spel-uchile/anemometroSonico/hardware/amplifier/amplifier_bom.xlsx

Quantity | SKU Digikey | Part number | Description | Reference
3 | 1276-1003-1-ND | CL21B104KBCNNNC | Capacitor 0.1uF (0805) | C101,C104,C105
1 | 1276-1029-1-ND | CL21B105KBFNNNE | Capacitor 1uF (0805) | C102
1 | 1276-2876-1-ND | CL31A106KBHNNNE | Capacitor 10uF (1206) | C103
1 | P1.00KFCT-ND | ERJ-8ENF1001V | Resistor 1k (1206) | R101
2 | LT1010CN8#PBF-ND | LT1010CN8#PBF | Power buffer LT1010 | U101,U103
1 | ED2609-ND | OSTTC022162 | Terminal block 2 pins | P101
2 | ED2610-ND | OSTTC032162 | Terminal block 3 pins | K101,K102
1 | INA2128UA-ND | INA2128UA | Instrumentation amplifier INA2128 | U102
1 | 1N4732ADICT-ND | 1N4732A-T | Zener diode 4.7v | D101
1 | P100FCT-ND | ERJ-8ENF1000V | Resistor 100 (1206) | R102
