spel-uchile/anemometroSonico/hardware/driver/driver_bom.xlsx

Quantity | SKU Digikey | Part number | Description | Reference
17 | 1276-1003-1-ND | CL21B104KBCNNNC | Capacitor 0.1uF (0805) | C101,C103,C104,C106,C109,C201,C301,C401,C203,C303,C403,C207,C307,C407,C208,C308,C408
13 | 1276-1029-1-ND | CL21B105KBFNNNE | Capacitor 1uF (0805) | C102,C107,C111,C113,C202,C302,C402,C204,C304,C404,C206,C306,C406
5 | 1276-2876-1-ND | CL31A106KBHNNNE | Capacitor 10uF (1206) | C110,C112,C205,C305,C405
2 | 475-1415-1-ND | LH R974-LP-1 | LED red (0805) | D101,D102
3 | 296-9911-5-ND | SN754410NE | H-Bridge SN754410 | IC201,IC301,IC401
15 | P10.0KFCT-ND | ERJ-8ENF1002V | Resistor 10k (1206) | R103,R104,R105,R201,R301,R401,R202,R302,R402,R203,R303,R403,R204,R304,R404
2 | P1.00KFCT-ND | ERJ-8ENF1001V | Resistor 1k (1206) | R101,R102
1 | ADG5207BRUZ-ND | ADG5207BRUZ | Analog multiplexer ADG5207 | U102
1 | LT1010CN8#PBF-ND | LT1010CN8#PBF | Power buffer LT1010 | U101
1 | CTX1164CT-ND | 445C25D20M00000 | Crystal oscilator 20 MHz (2010) | X101
2 | 1276-2607-1-ND | CL21C220JCANNNC | Capacitor 22pF (0805) | C105,C108
1 | WM3478-ND | 702461004 | AVR ISP connector | CON101
1 | ATMEGA328-AU-ND | ATMEGA328-AU | Atmega328 | IC101
2 | ED2609-ND | OSTTC022162 | Terminal block 2 pins | P101,P102
7 | ED2610-ND | OSTTC032162 | Terminal block 3 pins | K101,K201,K301,K401,K202,K302,K402
0.2 | A32705-40-ND | 9-103323-0 | Connector Header 90 deg | P103
