spel-uchile/anemometroSonico/hardware/usb_adc/usb_adc_bom.xlsx

Quantity | SKU Digikey | Part number | Description | Reference
1 | P1.00KFCT-ND | ERJ-8ENF1001V | Resistor 1k (1206) | R4
2 | ED2609-ND | OSTTC022162 | Terminal block 2 pins | P1,P2
1 | ED2610-ND | OSTTC032162 | Terminal block 3 pins | K1
14 | 1276-1017-1-ND | CL31B104KBCNNNC | Capacitor 0.1uF (1206) | C1,C2,C3,C7,C10,C11,C12,C13,C14,C15,C16,C17,C18,C19
3 | 1276-1191-1-ND | CL31F475ZOFNNNE | Capacitor 4.7uF (1206) | C5,C8,C9
2 | 1276-1285-1-ND | CL21C270JBANNNC | Capacitor 27pF (0805) | C4,C6
2 | P4.70KFCT-ND | ERJ-8ENF4701V | Resistor 4.7k (1206) | R1,R2
1 | P12KACT-ND | ERJ-6GEYJ123V | Resistor 12k (0805) | R3
1 | ADC122S706CIMT/NOPB-ND | ADC122S706CIMT/NOPB | Analog digital converter ADC122S706 | U1
1 | OP1177ARMZ-REELCT-ND | OP1177ARMZ-REEL | Operational amplifier OP1177 | UREF1
1 | TC1015-3.3VCT713CT-ND | TC1015-3.3VCT713 | Voltage Regulator 3.3v | UREG1
1 | 670-2595-1-ND | DX4R005H91R1500 | USB connector micro-b | USB_CONN1
1 | 631-1105-ND | FOXSLF/120-20 | Crystal oscilator 12 MHz | X1
1 | 768-1024-1-ND | FT2232HL-REEL | USB bridge FT2232HL | USB_SPI1
