spel-uchile/anemometroSonico/hardware/amplifier/amplifier.kicad_pcb

## KiCad design hardware/amplifier/amplifier.kicad_pcb (2013-12-23)

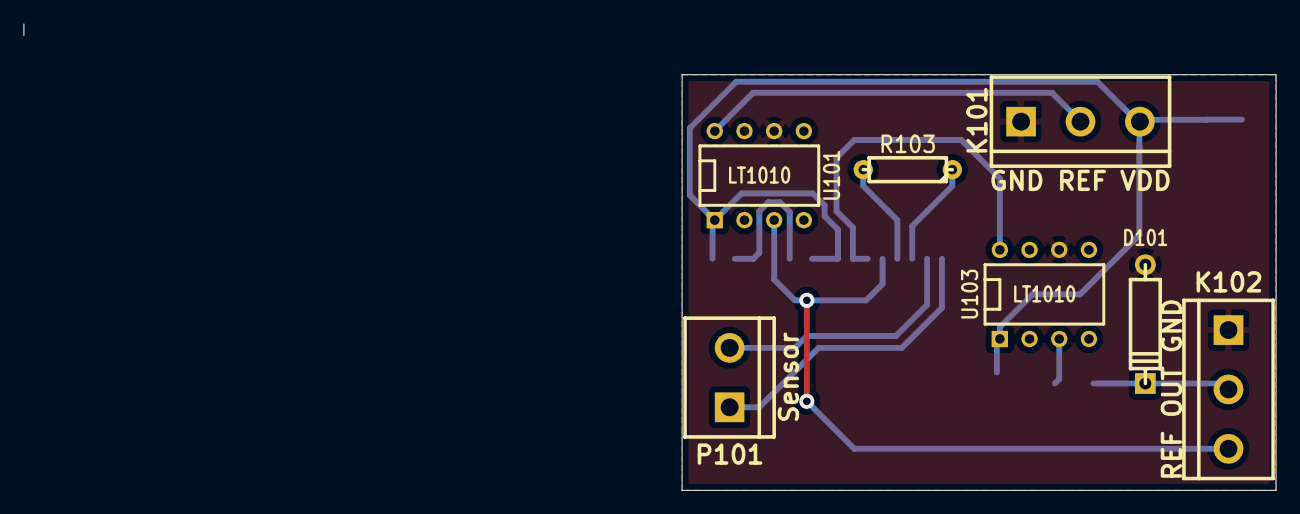
[picture p1: board amplifier.kicad_pcb from above]

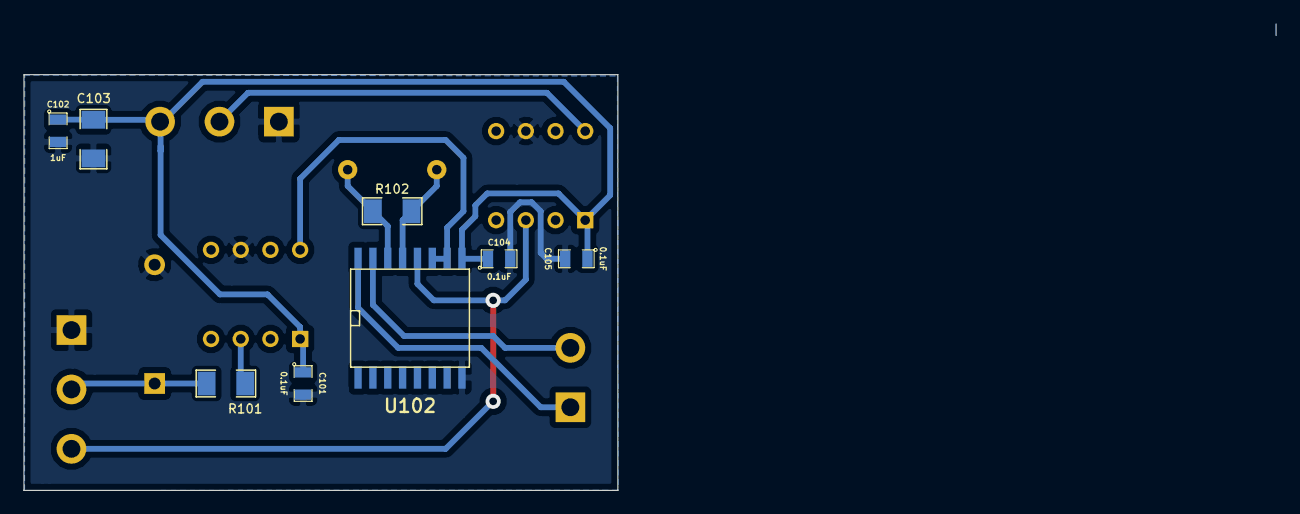
[picture p2: board amplifier.kicad_pcb from below]

Board: 2 copper layers, 50.8 x 35.6 mm, 15 parts (8 on the bottom side), 11 nets.

Parts:
C101, C104, C105: 0.1uF; SM0805
C102: 1uF; SM0805
C103: 10uF; SM1206
D101: 1N4732; D4
K101: GND REF VDD; bornier3
K102: REF OUT GND; bornier3
P101: Sensor; bornier2
R101: 1K; SM1206
R102: R; SM1206
R103: R; R3-LARGE_PADS
U101, U103: LT1010; DIP-8__300
U102: INA2128; SO16L

Connections:
/Se1: P101.2, U102.15
/Se2: P101.1, U102.16
/Vout: D101.2, K102.2, R101.1
/Vref: K102.3, U101.3, U102.12
/VrefIN: K101.2, U101.8
GND: C101.2, C102.2, C103.2, C104.2, C105.2, D101.1, K101.1, K102.1, U101.6, U102.8, U103.6
unnamed: U102.10, U102.11, U103.8
unnamed: R101.2, U103.3
unnamed: R102.2, R103.2, U102.13
unnamed: R102.1, R103.1, U102.14
VDD: C101.1, C102.1, C103.1, C104.1, C105.1, K101.3, U101.1, U102.9, U103.1
