spel-uchile/anemometroSonico/hardware/amplifier/amplifier.sch

## KiCad design hardware/amplifier/amplifier.sch (2013-11-28)

Schematic: amplifier.sch

Parts:
C101, C104, C105: 0.1uF
C102: 1uF
C103: 10uF
D101: 1N4732
K101: CONN_3
K102: Out
P101: Sensor
R101: 1K
R102, R103: R
U101, U103: LT1010
U102: INA2128; MODULE

Notes on the sheet:
Amplifier
Voltaje reference
INPUT/OUTPUT
Output stage
