spel-uchile/anemometroSonico/hardware/driver/driver.sch

## KiCad design hardware/driver/driver.sch (2013-11-27)

Schematic: driver.sch

Parts:
C101, C103, C104, C106, C109: 0.1u
C102, C107, C111, C113: 1u
C105, C108: 22p
C110, C112: 10u
CON101: AVR-ISP-10
D101, D102: LED
IC101: ATMEGA328P-A; TQFP32
K101: CONN_3
P101, P102: CONN_2
P103: CONN_6
R101, R102: 1k
R103, R104, R105: 10k
U101: LT1010; MODULE
U102: ADG5207; MODULE
X101: 20mhz

Notes on the sheet:
Input power filter
Power connector
Power indicators
Copyright UNIVERSIDAD DE CHILE 2013. This documentation describes Open Hardware and is licensed under the CERN OHL v.1.1 or later. You may redistribute and modify this documentation under the terms of the CERN OHL v.1.1. (http://ohwr.org/cernohl). This documentation is distributed WITHOUT ANY EXPRE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
