spel-uchile/anemometroSonico/hardware/driver/excitation.sch

## KiCad design hardware/driver/excitation.sch (2013-11-27)

Schematic: excitation.sch

Parts:
C201, C203, C207, C208: 0.1u
C202, C204, C206: 1u
C205: 10u
IC401: SN754410; HBridge-DIP16
K201, K202: CONN_3
R201, R202, R203, R204: 10k
