spel-uchile/anemometroSonico/hardware/usb_adc/usb_adc.sch

## KiCad design hardware/usb_adc/usb_adc.sch (2013-11-04)

Schematic: usb_adc.sch

Parts:
C1, C2, C3, C7, C10, C11, C12, C13, C14, C15, C16, C17, C18, C19: 0.1u
C4, C6: 27p
C5, C8, C9: 4.7u
K1: CONN_3
L1, L2: INDUCTOR
P1, P2: CONN_2
R1, R2: 5k
R3: 12k
R4: 1k
U1: ADC122S706; MODULE
UREF1: OP1771; MODULE
UREG1: TC1015; MODULE
USB_CONN1: MICRO-B_USB
USB_SPI1: FT2232H
X1: 12MHz

Notes on the sheet:
Copyright UNIVERSIDAD DE CHILE 2013. This documentation describes Open Hardware and is licensed under the CERN OHL v.1.1 or later. You may redistribute and modify this documentation under the terms of the CERN OHL v.1.1. (http://ohwr.org/cernohl). This documentation is distributed WITHOUT ANY EXPRE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
