spel-uchile/anemometroSonico/hardware/firmware/main.cpp

/*
 * Copyright (C) 2013  UNIVERSIDAD DE CHILE.
 *
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
 * Authors: Luis Alberto Herrera <herrera.luis.alberto@gmail.com>
 */


/* This is the main program of the controller of the adquisition board.
 * 
 * The controller is connected to the chip_select of the ADC, the drivers of
 * the transductors and the analog multiplexer selecting the input of the ADC.
 * When a falling edge is detected in the chip_select signal the controller
 * sends a pulse into one transducer while selecting the oposite one to be
 * sampled by the ADC.
 */

#include <avr/io.h>
#include <avr/interrupt.h>
#include <avr/sleep.h>
#include "pulse_generation.h"

// Number of pulses to excite the transducer.
#define EXCITATION_PULSES 3
// Number of tics (time) to listen the excitation signal.
#define DRIVING_TICKS 1
// Number of tics (time) to listen the echo signal.
#define LISTENING_TICKS 40
//
#define TRANSITION_TICKS 2

/* Pin allocation
 * PB0 => ADC select 0
 * PB1 => ADC select 1
 * PB2 => ADC select 2
 * PD2 => chip select
 * PD3 => pulse- signal
 * PD4 => pulse+ signal
 */

/* System State Machine.
 * The sistem state is evaluated in TIMER0 COMPARARTOR A interruption. The
 * following definitions control the state machine.
 */
// FSM states.
typedef enum {
  IDLE,
  DRIVE_NORTH,
  LISTEN_SOUTH,
  DRIVE_SOUTH,
  LISTEN_NORTH,
  DRIVE_EAST,
  LISTEN_WEST,
  DRIVE_WEST,
  LISTEN_EAST,
  TRANSITION1,
  TRANSITION2,
  TRANSITION3
} state_t;
// FSM current state.
state_t state_;
// FSM next state.
state_t next_state_;
// wheter we are waiting for an event to happen (to avoid scheduling an event
// twice).
bool timer0_running_ = false;


// schedule to evaluate the event next_state in ticks ticks.
void setup_timer(uint8_t ticks, state_t next_state) {
  if (!timer0_running_) {
    timer0_running_ = true;
    next_state_ = next_state;
    TCNT0 = 0;
    TCCR0B |= (1<<CS02) | (1<<CS00); //1024 preescaling
    TIMSK0 |= 1<<OCIE0A;
    OCR0A = ticks;
  }
}

ISR (INT0_vect)
{
  // The first event is delayed so the ADC is already taking samples.
  setup_timer(20, DRIVE_NORTH);
}

ISR(TIMER0_COMPA_vect) {
  timer0_running_ = false;
  TCCR0B &= 0xF8; //disable counter
  TIMSK0 &= ~(1<<OCIE0A); // disable interrupt
  state_ = next_state_;
  switch (state_) {
  case IDLE:
    PORTB = 0x06; // Pulse -> ADC
    break;
  case DRIVE_NORTH:
    PORTB = 0x00; // North -> ADC
    start_pulses(EXCITATION_PULSES, 0x01);
    setup_timer(DRIVING_TICKS, LISTEN_SOUTH);
    break;
  case LISTEN_SOUTH:
    PORTB = 0x01; // South -> ADC
    setup_timer(LISTENING_TICKS, TRANSITION1);
    break;
  case TRANSITION1:
    PORTB = 0x06; // Pulse -> ADC
    setup_timer(TRANSITION_TICKS, DRIVE_SOUTH);
    break;

  case DRIVE_SOUTH:
    PORTB = 0x01; // South -> ADC
    start_pulses(EXCITATION_PULSES, 0x02);
    setup_timer(DRIVING_TICKS, LISTEN_NORTH);
    break;
  case LISTEN_NORTH:
    PORTB = 0x00; // North -> ADC
    setup_timer(LISTENING_TICKS, TRANSITION2);
    break;
  case TRANSITION2:
    PORTB = 0x06; // Pulse -> ADC
    setup_timer(TRANSITION_TICKS, DRIVE_EAST);
    break;

  case DRIVE_EAST:
    PORTB = 0x02; // East -> ADC
    start_pulses(EXCITATION_PULSES, 0x04);
    setup_timer(DRIVING_TICKS, LISTEN_WEST);
    break;
  case LISTEN_WEST:
    PORTB = 0x03; // West -> ADC
    setup_timer(LISTENING_TICKS, TRANSITION3);
    break;
  case TRANSITION3:
    PORTB = 0x06; // Pulse -> ADC
    setup_timer(TRANSITION_TICKS, DRIVE_WEST);
    break;

  case DRIVE_WEST:
    PORTB = 0x03; // West -> ADC
    start_pulses(EXCITATION_PULSES, 0x08);
    setup_timer(DRIVING_TICKS, LISTEN_EAST);
    break;
  case LISTEN_EAST:
    PORTB = 0x02; // East -> ADC
    setup_timer(LISTENING_TICKS, IDLE);
    break;
  }
}

int main() {
  // I/O set up
  DDRB = 0xFF;
  PORTB = 0x06; // Pulse -> ADC
  DDRC = 0xFF;
  PORTC = 0x00;
  DDRD |= (1<<PD3) | (1<<PD4);
  PORTD |= (1<<PD3);

  // Set up interruption on falling edge of chip_select
  DDRD &= ~(1 << DDD2); // Set PD2 as input
  PORTD |= (1 << PORTD2); // turn on the pull-up on PD2
  EICRA |= (1 << ISC01); // set INT0 to trigger on falling edge
  EIMSK |= (1 << INT0);     // Turns on INT0_vect
  sei();
  
  while(1) {
    sleep_mode();
  }
  
  return 0;
}
