spel-uchile/anemometroSonico/software/adc_reader.h

//
// Copyright (C) 2013  UNIVERSIDAD DE CHILE.
//
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
// Authors: Luis Alberto Herrera <herrera.luis.alberto@gmail.com>

#ifndef ADC_READER_H_
#define ADC_READER_H_

#include <cstdint>

// Frame size in number of samples.
static const int kFrameSize = 10000;

struct mpsse_context;

// This class provides access to the hardware of the anemometer.
//
// This connection is implemented using an analog-digital converter (ADC)
// connected to the USB through an SPI-USB bridge.
class ADCReader {
 public:
  // Opens a communication channel with the underlying ADC.
  ADCReader();
  // Closes the communication channel with the underlying ADC.
  ~ADCReader();

  // Reads one frame of data from the anemometer. This frame consists of two
  // measurements per direction. Each direction includes the excitation signal
  // on one transducer and the echo of the paired transducer.
  void GetFrame(double *buffer, int buffer_size);
  // Converts a single reading from the ADC format to double.
  static double ConvertFromADCFormat(int16_t data);

  // Perform repetitions calls to get frame and store them in the matrix pointed
  // by buffer.
  void GetNFrames(double *buffer, int repetition, int samples);

 private:
  // Communication interface with the ADC.
  struct mpsse_context *adc_;
  // Buffer to store the data from adc. It is reused between calls for
  // efficiency.
  int16_t *reading_buffer_;
  // Speed of the communication with the ADC. Every sample is put in two bytes
  // so the actual sampling rate can be calculated as kSpiClock/16. The maximum
  // speed of the ADC (16 MHz) cannot be achieved since the USB interface has a
  // clock of 30 MHz (only generates frecuencies that are divisors of 30MHz).
  static const int kSpiClock = 15000000;

  // Disallow copy and assign.
  ADCReader(const ADCReader &);
  ADCReader &operator=(const ADCReader &);
};

#endif  // ADC_READER_H_
