spel-uchile/anemometroSonico/software/plot_from_adc.py

# Example of how to use adc_reader. It will plot one frame.

import adc_reader
import numpy as np

from pylab import *

data = np.zeros(adc_reader.kFrameSize)

reader = adc_reader.ADCReader()
reader.GetFrame(data)

plot(data)
show()
