spel-uchile/anemometroSonico/(commit log)

2013-10-22 Added design of ADC-USB board.
    This boards allows to connect an Analog Digital Converter to a computer
    using the USB bus.
    [usb_adc.brd, usb_adc.sch]
2013-10-24 Bug fix: Increased via size for ADC-USB board.
    [usb_adc.brd, usb_adc.sch]
2013-11-04 Added schematic and pcb for driving the transductors and selecting an input for the ADC.
    [driver.brd, driver.sch]
2013-11-04 Increased via size for driver board.
    [driver.brd, driver.sch]
2013-11-04 Replacement of analog switches with H-bridges.
    [driver.sch]
2013-11-05 Excitation circuit moved to hierarchical sheet.
    [driver.sch, excitation.sch]
2013-11-06 Added voltage reference VCC half using a power opamp.
    [driver.sch]
2013-11-06 Added "Input Common-Mode Current Path".
    [excitation.sch]
2013-11-06 Replace 5V analog multiplexer by high voltage analog multiplexer.
    [driver.sch]
2013-11-06 Addition of some decoupling capacitors.
    [driver.sch, excitation.sch]
2013-11-06 Added input power connector. Including input power filter and indicating leds.
    [driver.sch]
2013-11-06 Change connector from 2 to 3 pins to provide connection to cable shielding.
    [excitation.sch]
2013-11-06 Added serial communication interface (FTDI connector).
    [driver.sch]
2013-11-06 Changed led resistor value.
    [driver.sch]
2013-11-06 Schematics references naming.
    [driver.sch, excitation.sch]
2013-11-06 Footprint association.
    [driver.sch, excitation.sch]
2013-11-07 Board design for the driver module.
    [driver.brd, driver.sch, excitation.sch]
2013-11-08 ADCReader binding for python using SWIG + numpy.
    [adc_reader.cc, adc_reader.h, adc_reader_test.cc, plot_from_adc.py]
2013-11-12 Data preprocessing: Split frame and data sanity check functions
2013-11-18 Added amplifier board.
    Amplifier board takes an input voltage in the range of the transducer
    voltage and outputs the differential signal amplified by a constant gain
    and trimmed to 0-5V.
    [amplifier.kicad_pcb, amplifier.sch]
2013-11-27 Amplifier board: change instrumentation amplifier for INA2128.
    [amplifier.kicad_pcb, amplifier.sch]
2013-11-27 Moved power connector.
    [amplifier.kicad_pcb]
2013-11-28 Placing of component designators on silk screen.
    [amplifier.kicad_pcb, driver.brd, usb_adc.brd]
2013-11-29 Implementation of a state machine to switch between driving and listening a transducer.
    The FSM is implemented using the TIMER0 on the Match Comparator A interrupt. So
    far the two states working are DRIVE_NORTH and LISTEN_SOUTH. The start of the
    measuring sequence is delay to allow proper working of the ADC.
2013-11-29 Adapt firmware to driver board.
2013-11-29 Time adjustements of driver firmware.
2013-11-29 Updates for new excitation board.
2013-12-16 Function to read several frames.
2013-12-23 Added bill of materials with digikey codes.
    [amplifier_bom.xlsx, driver_bom.xlsx, usb_adc_bom.xlsx]
